kriszabala/Arduino-Hobart-LXI/(commit log)

2020-08-25 Initial Commit
    Bare bones implementation with working door and wash button inputs, water level sensing and pre-wash activation.
2020-08-25 Implements progression of cycle stages.
    Upon user pressing the wash button, the machine will progress through idle, pre-fill, pre-wash, wash, and rinse stages. Also implements open door safety checks.
2020-09-03 Fixes rinse start and finish detection
    [Arduino-Hobart-LXI.ino]
2020-09-03 Update Readme with control board image
